AlanoudAlsalem/Dimver/report.pdf

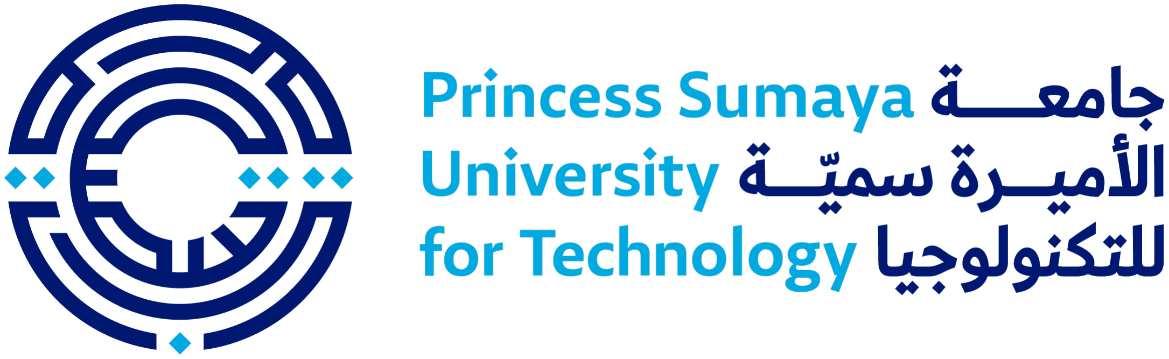
[picture p1: figure]

22583 - INTRODUCTION TO ROBOTIC SYSTEMS

PRINCESS SUMAYA UNIVERSITY FOR TECHNOLOGY

DEPARTMENT OF COMPUTER ENGINEERING

# Mobile Robot with Robotic Arm for Object Handling

Authors:
Qabas Alkaissi | (ID: 20210786)
Alanoud Alsalem | (ID: 20210371)
Leen Almousa | (ID: 20210268)
Qais Jildeh | (ID: 20210155)

### Motasem Amaireh (ID: 20190430)

Date: January 11, 2026

CONTENTS | CONTENTS

## Contents

1 Introduction | 7
2 System Overview | 7
3 Simulation Environment | 11
4 Slip Detection and Traction Control | 13
5 Data Engineering | 15
6 Machine Learning Approach | 18

CONTENTS | CONTENTS
7 Real-Time Deployment & Control | 20
8 Global Vision & Localization | 22
8.4 Software Architecture: Laptop Vision UI & Raspberry Pi Controller . . . | 25
9 Experimental Results | 31
10 Conclusion | 36

LIST OF FIGURES | LIST OF FIGURES

## List of Figures

1 | 2-DOF Planar Arm Model showing kinematic parameters (L,θ) and dy-
| namic parameters (m,τ) | | 8
2 | Visual representation of the gravitational term G(θ) in the Euler-Lagrange
| equation. The torque depends on the horizontal projection of the center
| of mass | | 9
3 | Cirkit Design schematic illustrating the physical wiring and pin connections 10
4 | Visualization of the mobile manipulator in Gazebo (left) and RViz (right). 13
5 | Free Body Diagram of the wheel showing Torque (τ), Friction Force (Ff ),
| and Normal Force (N) | | 14
6 | Divergence of wheel speed (green) and ground speed (red) during in-
| duced slip events. The delta between the two signals constitutes the
| supervised learning target | | 17
7 | Distribution of the training dataset (N = 50,000) spanning both high-slip
| (Wall Impact) and low-slip (Normal Driving) regimes | | 20
8 | High-level closed-loop traction control system. Sensors feed real-time
| velocity data to the controller, which adjusts motor commands to prevent
| slip | | 21
9 | Finite-state machine representation of the ML-based traction controller. . | 21
10 | Calibration Pipeline from raw frame input to the output localization . . . | 23
11 | AprilTag mounted on the mobile robot for pose estimation | | 24
12 | System Architecture: Global Vision Localization. The camera {C} ob-
| serves the tag on the robot {R} to determine its position in the world
| frame {W } | | 25
13 | RMSE Reprojection Error | | 31
14 | Experimental trajectory of the mobile robot. The blue trace indicates
| the actual path recorded by the global vision system, while red markers
| denote the sequential target waypoints | | 32
15 | System step response and convergence analysis. Vertical spikes indicate
| the reception of new goal commands, followed by exponential decay in
| position error | | 33
16 | Operational timeline showing state transitions. The correlation between
| ’Stationary’ phases (Grey) and ’Arm Events’ (Red lines) confirms that idle
| time was utilized for manipulation tasks | | 34
17 | Vision system availability map. Green regions indicate valid tracking,
| while red regions represent signal loss due to occlusion, handled by the
| FSM safety logic | | 34

LIST OF TABLES | LIST OF TABLES
18 | Slip Dynamics (|λˆ|). (a) The unmitigated controller (red) exhibits er-
| ratic slip behavior with sustained violations of the stability threshold
| (λth = 0.2). (b) The proposed ML+FSM controller (blue) rapidly detects
| incipient slip and modulates velocity, triggering a fast recovery (0.16s)
| and preventing loss of control | | 35

## List of Tables

1 | Dimensions and masses of the mobile manipulator extracted from the
| URDF | | 11
2 | PID gains for the arm trajectory controller, taken from the YAML config-
| uration | | 12
3 | Slip detection and mitigation parameters | | 22
4 | UDP command messages (Laptop → Raspberry Pi) | | 28
5 | Comparison of slip mitigation strategies. *The Threshold Clamp failed to
| regain traction, spinning in place for the full duration, rendering position
| error invalid | | 35

LIST OF TABLES | LIST OF TABLES

## Abstract

This work presents the design, modeling, and simulation of a mobile manipulation system that integrates navigation, manipulation, learning-based slip estimation, and vision-based localization within a unified control framework. A key challenge addressed is wheel slip, which violates the no-slip assumptions underlying classical mobile robot kinematics and leads to degraded odometry and control performance.

To address this, a supervised learning–based slip estimation model is trained using simulation-generated data, leveraging direct access to ground-truth dynamics during offline training while relying solely on onboard proprioceptive sensing during deployment. The learned slip estimator is embedded within a real-time finite-state traction controller that dynamically adapts wheel commands to maintain stability under low-traction conditions.

The complete system is implemented and evaluated in a ROS–Gazebo environment, combining analytical kinematic modeling, data-driven learning, and structured control logic. Experimental results demonstrate stable navigation, effective slip mitigation, and robust operation despite significant perception outages in the global vision system, highlighting the benefits of hybrid analytical–learning approaches for mobile manipulation under realistic physical constraints.

2 SYSTEM OVERVIEW

## 1 Introduction

This project focuses on the design and simulation of a mobile robot equipped with a robotic arm for autonomous navigation and object handling. The system integrates modeling, control, machine learning, and vision to address real-world challenges such as wheel slip and localization uncertainty.

### 1.1 Objectives

- To design a mobile manipulator capable of navigation and object handling.
- To derive and implement the kinematic model required for arm control.
- To develop a realistic simulation environment for validation and data generation.
- To detect and estimate wheel slip using machine learning and proprioceptive data.
- To integrate slip estimation into a real-time traction control framework.
- To implement a global vision localization and evaluate overall performance.

### 1.2 Problem Statement

Conventional mobile robot control and localization frameworks assume ideal rolling conditions and reliable sensing. In practice, wheel slip, actuator limits, and sensor occlusions introduce errors that accumulate over time and can lead to unstable behavior or task failure. The problem addressed in this work is how to reliably estimate and mitigate wheel slip, while maintaining accurate control and localization in a mobile manipulation system, using only onboard sensing and simulation-derived learning [11][8].

## 2 System Overview

### 2.1 Mathematical Modeling

### 2.1.1 Manipulator Forward Kinematics

Forward kinematics allows us to calculate the Cartesian position (x,y) of the end-effector (the gripper) relative to the robot’s base frame, given the joint angles θ1 and θ2

We assume the arm operates in a 2D plane. Using simple geometry and trigonometric projections, the position equations are:

x = L1 cos(θ1

) + L2 cos(θ1 + θ2

)
y = L1 sin(θ1

) + L2 sin(θ1 + θ2

)

where:

2.1 Mathematical Modeling | 2 SYSTEM OVERVIEW

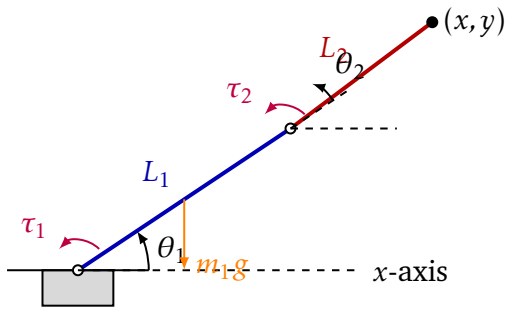
[picture p2: figure]
x-axis

Figure 1: 2-DOF Planar Arm Model showing kinematic parameters (L,θ) and dynamic parameters (m,τ).

- L1

,L2 are the lengths of the first and second links, respectively.
- θ1

is the angle of the first link relative to the base x-axis.
- θ2

is the angle of the second link relative to the first link.

### 2.1.2 Manipulator Inverse Kinematics

Inverse kinematics is required to determine the necessary joint angles (θ1

,θ2) to reach
a specific target coordinate (x,y). We utilize the geometric approach (Law of Cosines) to solve for these angles. First, we solve for the elbow angle, θ2

. By visualizing a triangle formed by L1

, L2

, and the distance to the origin r =

p
x

2 + y

2, we apply the Law of
Cosines:

cos(θ2

) =

x

2 + y

2 − L

2
1

− L

2
2
2L1L2
Thus, θ2 can be calculated as:

θ2 = atan2
±

q
1 − cos²(θ2
),cos(θ2

)

Next, we solve for the base angle, θ1

:

θ1 = atan2(y, x) − atan2(L2 sin(θ2

),L1 + L2 cos(θ2

))

### 2.1.3 Forces & Torques for Arm Motion

To control the arm effectively, we must determine the torques (τ) required at each joint to achieve desired accelerations. We model the dynamics using the Euler-Lagrange[10] equation:

τ = M(θ)θ¨ + C(θ,θ˙ ) + G(θ) | (1)

Where:

2 SYSTEM OVERVIEW | 2.2 Electrical Design
- θ = [θ1
,θ2

]

T
is the vector of joint angles.
- M(θ) is the symmetric Inertia Matrix.
- C(θ,θ˙
) represents Coriolis and Centrifugal forces.
- G(θ) represents Gravitational forces.

Lever Arm = Lc cos(θ)

r = Lc

Axis of
Rotation

F = mg

θ

### Gravitational Term G(θ)

Figure 2: Visual representation of the gravitational term G(θ) in the Euler-Lagrange equation. The torque depends on the horizontal projection of the center of mass.

### 2.2 Electrical Design

This subsection presents an overview of the proposed mechanical structure and electrical architecture of the robot. The system incorporates various sensors, actuators, and controllers that work together to ensure reliable motion and sensing, while enabling coordinated operation of all components within the overall system.

### 2.2.1 Circuit Setup

an electrical circuit diagram of the robot system was created using cirkit design. This diagram depicts the physical wiring and pin connections between all three of the major components (controllers, sensors, and actuators). The diagram serves as a reference for how each component is electrically connected rather than describing the internal control logic of the system. The MegaPi controller is connected to two IR sensors, two impact sensors, and two line follower sensors via digital and analog input pins, as well as four DC motors connected to the MegaPi motor ports, which power the mecanum wheel mechanism, allowing movement of the robot. Three servo motors are connected to the Raspberry Pi which actuate the 2DOF robotic arm; the motors receive power from

2.2 Electrical Design | 2 SYSTEM OVERVIEW

an external 5v, however the control signals are coming from the appropriate GPIO pins of the Raspberry Pi. The Raspberry Pi and the MegaPi are connected via USB, allowing communication between the two boards while maintaining separate wiring for sensors, motors, and servos. The presented circuit design ensures correct signal routing, stable operation, and ease of implementation during system assembly.

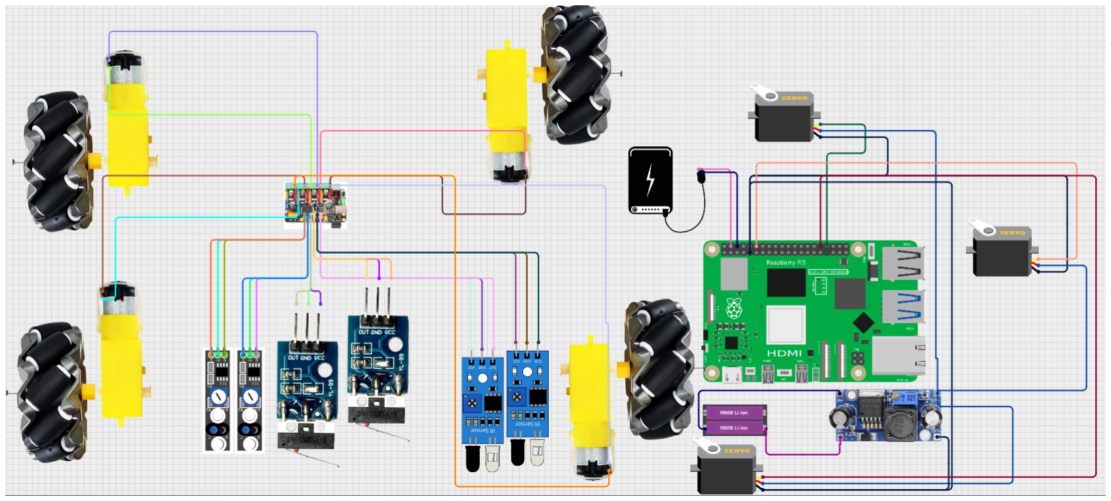
[picture p3: figure]

Figure 3: Cirkit Design schematic illustrating the physical wiring and pin connections

### 2.2.2 Differential Drive

The robot has four DC motors, and its mechanical configuration features mecanum wheels and allows for omnidirectional movement. The robot can move forward or backward, sideways and rotate around its vertical axis; each wheel is independently powered so that it may move independently of the others. Motor speed and direction are regulated by a MegaPi controller, which maintains an optimal velocity for each wheel to allow for controlled lateral movement. This extends the concept of traditional differential drive by allowing for additional degrees of freedom which enhances its capability to navigate through visually restricted areas.

### 2.2.3 Power & Energy Considerations

Power management considerations have been given serious thought to maintain the robot system’s consistent and dependable operation under diverse loading situations. Servos draw high amounts of current and exhibit rapid snap action, this, the robotic arm subsystem has been designed to operate independently from the rest of the robot. Thus, three servos that actuate the 2-DOF robotic arm are driven by a 7.2 V external battery and fed through a regulated DC-DC voltage converter at an output voltage of around

3 SIMULATION ENVIRONMENT

5-6 V to meet the required operating voltage for the servo motors, which will prevent excessive loading on the primary power supply circuit and lessen the risk of voltage drops occurring during arm motion. All of the remaining components of the system are powered through a power bank that is connected to the Raspberry Pi and provides a stable voltage for computation, sensing, and mobile navigation, which also simplifies the overall method of power distribution across the robot. By selecting different power sources to power the high-current actuators and sensitive electronic devices separately, the system reduces EMC noise, enhances system reliability, and promotes consistent operation during simultaneous robot operation and motion of the robot arm.

## 3 Simulation Environment

A ROS–Gazebo simulation was developed to evaluate the mobile manipulator. The simulation environment provides a repeatable platform for testing the robot model, its controllers, and the interaction between the mobile base and the manipulator arm before deployment on real hardware.

### 3.1 Robot Model and Mechanical Design

The robot is described using URDF, which defines its geometry, kinematic structure, inertial properties, and collision models. The complete system consists of:

- A four–wheel skid–steer mobile base.
- An arm base pedestal and waist assembly.
- A vertical pillar link mounted to a gripper with two prismatic fingers coupled through a mimic joint.

All geometric dimensions and masses used in the simulation are taken directly from the URDF and are summarized in Table 1.

Component | Dimensions | Mass
Base chassis (base link) | 190 × 140 × 57.5mm | 1.3103kg
Drive wheel (each) | 60 × 25mm | 44g
Arm base pedestal (arm base pedestal) | 25 × 55 × 45mm | 83g
Waist housing (link waist) | 25 × 55 × 65mm | 25g
Main pillar link (arm pillar link) | 25 × 43 × 105mm | 126g

Table 1: Dimensions and masses of the mobile manipulator extracted from the URDF.

The gripper fingers are actuated through a prismatic joint gripper joint, while the second finger moves symmetrically through gripper joint mimic using a mimic rela-

3.2 Control Configuration | 3 SIMULATION ENVIRONMENT

tionship with multiplier −1.0. This configuration produces synchronized, symmetric opening and closing of the gripper.
Realistic inertial parameters (mass, center of mass) are specified for each link. These values suppress unrealistic accelerations and oscillations and lead to physically consistent motion in Gazebo.

### 3.2 Control Configuration

Joint-level control is implemented using the ros control framework. A joint state controller publishes the current joint states at 50Hz, while a joint trajectory controller commands the arm joints (joint1, joint2, and gripper joint) in position mode. The main PID gains for the trajectory controller are defined in an external YAML configuration file and are summarized in Table 2. Separate PID gains are also selected for the gazebo ros control plugin, which provides additional stabilization of the joints.

Joint | P | I | D
joint1 | 100.0 | 0.1 | 10.0
joint2 | 100.0 | 0.1 | 10.0
gripper joint | 50.0 | 0.01 | 1.0

Table 2: PID gains for the arm trajectory controller, taken from the YAML configuration.

Trajectory constraints are also set in the YAML file, including a goal completion time of 0.6s and a stopped-velocity tolerance of 0.05rad/s, with tighter goal tolerances for the individual joints. These settings ensure smooth convergence to the target configuration without excessive overshoot.
The mobile base is controlled through a skid–steer drive plugin. Velocity commands issued on cmd vel are translated into wheel velocities for the four wheel joints using the specified wheel separation of 165mm and wheel diameter of 60mm. In parallel, the manipulator arm is controlled by a joint trajectory controller, which receives desired joint trajectories and computes the corresponding position commands for joint1, joint2, and gripper joint. This allows the arm and mobile base to be operated together in a coordinated manner during the simulation.

### 3.3 Dynamics and Validation

The Gazebo physics engine simulates gravity, friction, contact interactions, and joint dynamics.
The simulation was used to assess:
- Tracking accuracy of joint1, joint2, and the prismatic gripper joint.
- Stability of the arm under different motion speeds.

4 SLIP DETECTION AND TRACTION CONTROL

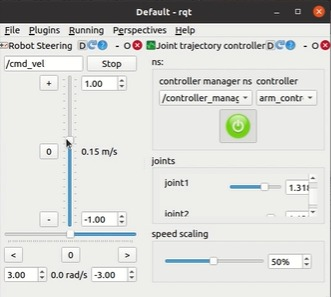
[picture p4: figure]
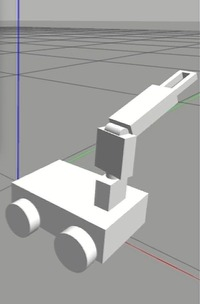
[picture p5: figure]

Figure 4: Visualization of the mobile manipulator in Gazebo (left) and RViz (right).

- Coordinated opening and closing of the mimic gripper.
- Combined operation of the mobile base and manipulator.

The final configuration exhibited smooth, stable motion. The link dimensions and masses derived from the URDF produced realistic dynamic behavior, indicating that the model, controllers, and plugins are correctly integrated and that the system is functional.

## 4 Slip Detection and Traction Control

Most mobile robots assume no-slip conditions during motion. This assumption often breaks down in unstructured environments such as mud, ice, or during collisions, resulting in odometry drift and eventual localization failure. Slip cannot be measured directly without costly external sensing systems, which motivates the need to infer slip from internal proprioceptive data.

While slip is classically defined as a normalized ratio, this work models slip as the absolute divergence between wheel-induced velocity and ground-truth velocity. This formulation is more directly actionable for real-time control, as it maps linearly to velocity correction commands. A nonlinear regression model can be employed to estimate the unobservable slip state, λ, using only observable quantities: wheel angular velocity ωw and commanded velocity vcmd.

4.1 Mathematical Definition of Slip 4 SLIP DETECTION AND TRACTION CONTROL

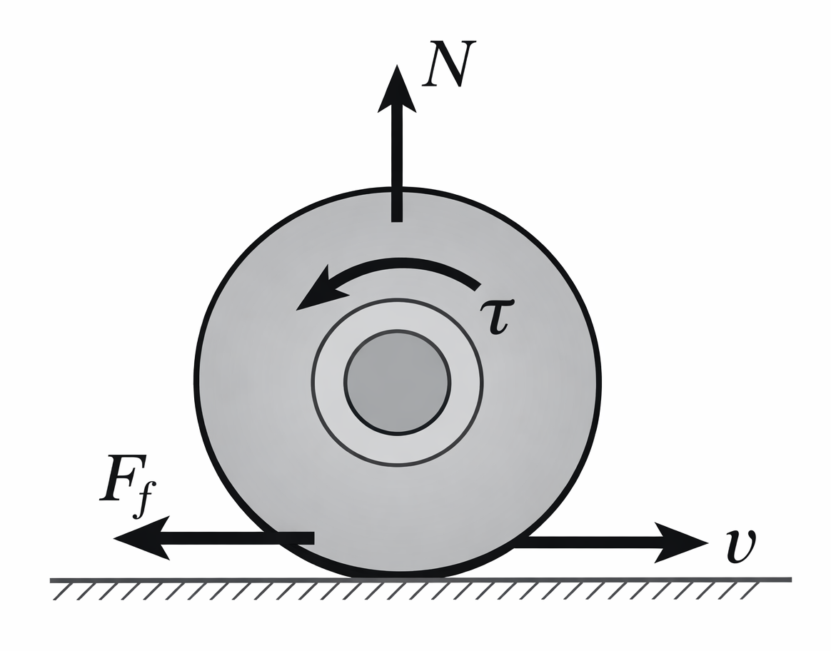
[picture p6: figure]

Figure 5: Free Body Diagram of the wheel showing Torque (τ), Friction Force (Ff ), and Normal Force (N)

### 4.1 Mathematical Definition of Slip

Slip is defined as the discrepancy between the wheel-induced motion and the actual ground motion of the robot[8, 4]. The slip ratio is given by

λ = 1 −

vground

r · ωwheel

(2)

where:

- λ is the slip ratio, with λ = 0 indicating pure rolling and λ = 1 indicating burnout,
- vground is the true linear velocity of the robot relative to the ground (ground truth),
- ωwheel is the angular velocity of the wheel,
- r is the wheel radius, fixed at r = 0.03m.

All experiments were conducted using the Gazebo simulator, which employs the Open Dynamics Engine (ODE) to solve rigid body dynamics and contact interactions. Gazebo was selected due to its widespread adoption in robotics research and its ability to expose low-level physical parameters relevant to wheel–terrain interaction.

### 4.1.1 Slip-Inducing Physics Configuration

To ensure the presence of wheel slip during simulation, the default contact and actuation parameters in Gazebo were intentionally modified. Under nominal settings, the physics engine implicitly enforces near no-slip behavior by limiting wheel torque and angular velocity, effectively preventing sustained wheel spin under load.
To emulate low-traction, ice-like terrain conditions, both the primary and secondary friction coefficients were reduced to

5 DATA ENGINEERING

µ = µ2 = 0.1 | (3)
Additionally, the joint actuation limits were increased to allow free wheel rotation under resistive contact:
- The max. joint effort (max effort) was increased to 20.0,
- The joint velocity constraint was relaxed to permit sustained wheel spin.

These modifications enable the simulation of extreme slip regimes, including burnoutlike behavior, while maintaining physically consistent rigid body dynamics.

### 4.1.2 Hidden Sensor Method

Standard odometry outputs (e.g., the /odom topic) rely on no-slip kinematic assumptions and therefore become unreliable under slip conditions. To avoid this limitation, raw wheel joint states were extracted directly from the /joint states topic, providing access to low-level proprioceptive measurements unaffected by odometry fusion.
The wheel-induced linear velocity was computed by averaging the angular velocities of all four wheels and mapping them to linear motion as

vwheel =

1
4

X

4

i=1

θ˙
i
·r | (4)

where:
- θ˙
i denotes the angular velocity of the i-th wheel.
- r is the wheel radius.

This formulation assumes symmetric wheel geometry and equal contribution from each driven wheel. The resulting vwheel signal, together with the commanded velocity vcmd, forms the observable input space used for slip estimation.

## 5 Data Engineering

### 5.1 Automated Data Generation Pipeline

### 5.1.1 Methodology: Automated Simulation Control

Data collection was fully automated via a Python script (collect data.py) that orchestrates the Gazebo simulation loop, robot actuation, and sensor logging. Each trial consists of issuing a commanded velocity, recording wheel kinematics, and exporting synchronized state vectors at a fixed simulation timestep.
The automation ensures scalability and eliminates human bias, enabling the generation of large, statistically meaningful datasets suitable for supervised learning[14, 13].

5.1 Automated Data Generation Pipeline | 5 DATA ENGINEERING

### 5.1.2 State Reset and I.I.D. Trials

To guarantee independent and identically distributed (I.I.D.) samples, the simulation environment is treated as a memoryless system between trials. Simply driving the robot back to the start is insufficient, as it introduces residual integrator error and non-zero momentum.
Instead, a ”hard reset” is enforced using the Gazebo state API. Let the robot state vector x(t) be defined as the concatenation of pose and twist:

x(t) =

p(t)
q(t)
v(t)
ω(t)

∈ R
13 | (5)

Where p is Cartesian position, q is the quaternion orientation, v is linear velocity, and ω is angular velocity.
At the initialization of every trial k, the state is forced to a fixed initial condition x0

,
ensuring zero variance in the starting distribution:

xk

(t = 0) ← x0 =

03×1
[0,0,0,1]T

03×1
03×1

(6)

This operation effectively zeros out all kinetic energy (Ek =

1
2mv² = 0), preventing historical velocity correlations from contaminating the subsequent dataset.
This reset enforces identical initial conditions across runs, preventing temporal correlation and trajectory memory from contaminating the dataset. As a result, each slip event is treated as an independent realization of the underlying physical process.

### 5.1.3 Variance Injection via Environment Extremes

To maximize model generalization, variance was deliberately injected by collecting data under two extreme environmental conditions:

- Wall Impact (100% Slip): Induced by commanding motion into an immovable obstacle, forcing wheel rotation without ground displacement.
- Empty World (0% Slip): Free-space motion on uniform terrain, representing nominal traction conditions.

The merged dataset exposes the model to the full slip spectrum, preventing biased learning and improving robustness under real-world ambiguity.

5 DATA ENGINEERING | 5.2 Visual Evidence of Slip Dynamics

### 5.1.4 Dataset Specifications

The final dataset characteristics are summarized as follows:

- Total Samples (N): ∼ 50,000 (merged dataset)
- Sampling Rate: 100 Hz (Gazebo simulation step)
- Feature Vector:
X = [vcmd, vwheel] | (7)
- Target Variable:
y = vwheel − vground | (8)

This formulation directly models slip as the divergence between wheel-induced motion and actual ground displacement.

### 5.2 Visual Evidence of Slip Dynamics

The characteristic “alligator mouth” shape highlights the non-linear and discontinuous nature of slip, motivating the choice of non-linear regression models.

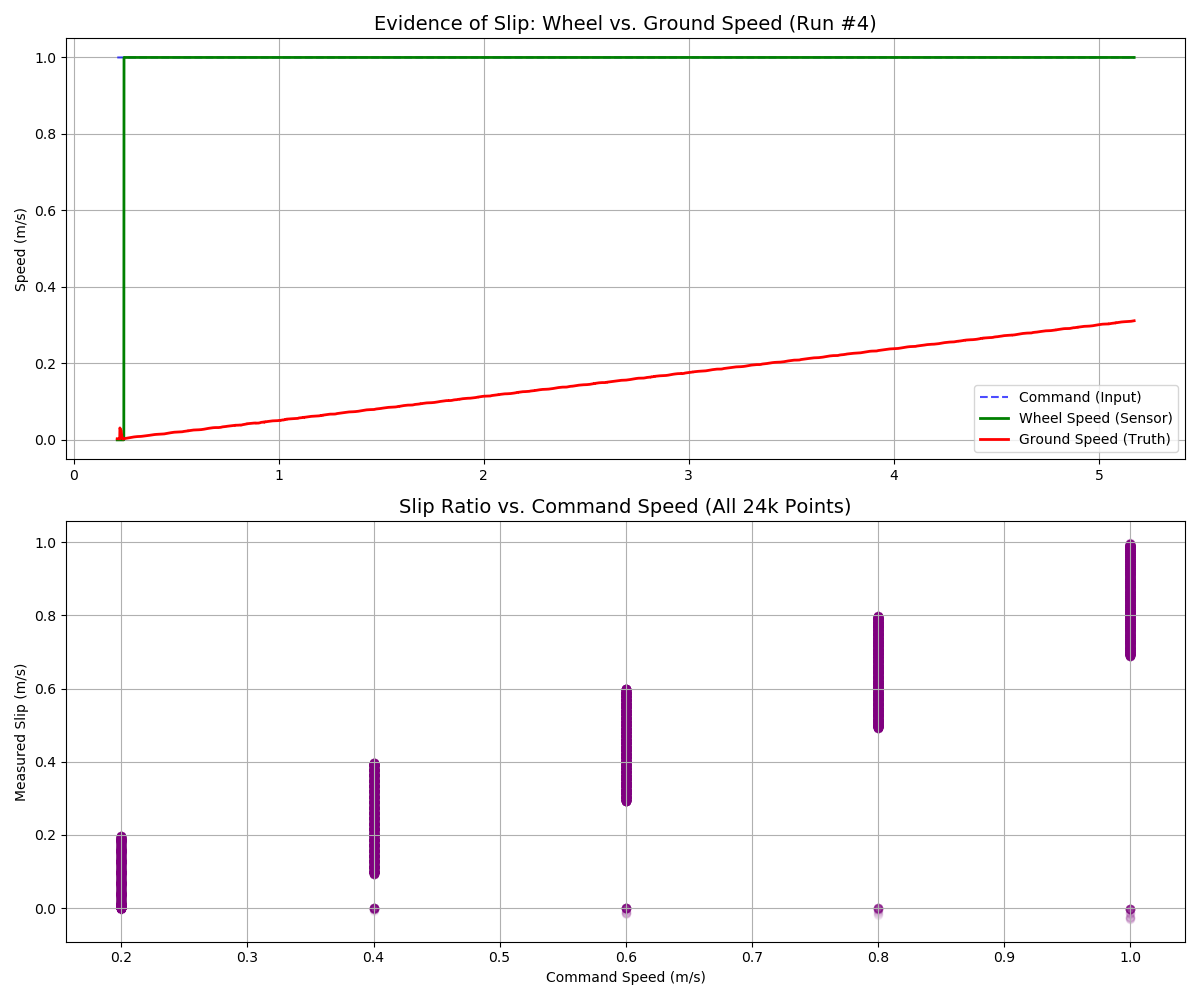
[picture p7: figure]

Figure 6: Divergence of wheel speed (green) and ground speed (red) during induced slip events. The delta between the two signals constitutes the supervised learning target.

6 MACHINE LEARNING APPROACH

## 6 Machine Learning Approach

### 6.1 Model Selection: Random Forest Regressor

A Random Forest Regressor was selected to estimate slip magnitude from proprioceptive inputs[15, 7]. Random Forests provide strong non-linear modeling capacity with minimal tuning overhead.

Linear regression was not used because it fails to capture the underlying dynamics due to the inherently non-linear relationship between commanded velocity, wheel rotation, and traction. Empirically, slip manifests as a discontinuous, staircase-like response rather than a smooth linear trend.

Neural Networks were also not used for the ML Approach. Although neural networks are expressive, they were deemed unnecessary for this task due to:

- Limited feature dimensionality
- Increased training complexity
- Higher risk of overfitting given synthetic data

The Random Forest model offers various advantages, including robustness to sensor noise, implicit regularization via ensemble averaging, and interpretability through feature importance analysis.

### 6.2 Performance Metrics and Validation

### 6.2.1 Evaluation Results

Model performance was evaluated using a standard 80/20 train-test split, where 80% of the dataset was used for training and the remaining 20% was held out for evaluation. Performance was quantified using the coefficient of determination (R

2
) and the
mean squared error (MSE), which together assess both explanatory power and absolute prediction accuracy.

Coefficient of Determination (R

2
). The coefficient of determination measures the proportion of variance in the target variable explained by the regression model and is defined as:

R

2 = 1 −

PN
i=1(yi − yˆi

)

2
PN
i=1(yi − y¯)

2

(9)

where:

- yi denotes the ground-truth slip value
- yˆi

the model prediction

6 MACHINE LEARNING APPROACH 6.3 Ground Truth and Slip Label Generation

- y¯ the mean of the ground-truth values
- N the number of test samples

An R

2
score of approximately 0.95 indicates that the model has a strong alignment between predicted and true slip dynamics across diverse operating conditions.

Mean Squared Error (MSE). The mean squared error quantifies the average squared deviation between predicted and true values and is given by:

MSE =

1
N

X

N

i=1

(yi − yˆi

)

2
(10)

Unlike R

2
, MSE preserves the physical units of the target variable squared, providing an absolute measure of prediction accuracy. The low observed MSE indicates that prediction errors remain tightly bound, even during high-slip transients.

Metric Complementarity. While R

2 evaluates how well the model explains variance in slip behavior, MSE reflects the magnitude of residual errors. Reporting both metrics provides a balanced assessment, ensuring that high variance explanation does not mask large absolute errors in critical slip regimes.

### 6.2.2 Bias and Overfitting Correction

An initial version of the model exhibited false-positive slip detection on flat, hightraction terrain. This bias was traced to an overrepresentation of slip-heavy scenarios in the training data. The issue was mitigated by injecting additional control data from Empty World simulations, effectively anchoring the model’s baseline behavior. This correction significantly reduced false detections without degrading sensitivity to genuine slip events.

### 6.3 Ground Truth and Slip Label Generation

Slip cannot be directly measured in real-world deployments without external sensing infrastructure. However, simulation provides direct access to ground-truth robot kinematics. The true ground velocity vground was extracted from the simulator state and used exclusively for offline label generation.
For each timestep, the slip target was computed as:
λ = vwheel − vground | (11)

The slip labels were stored alongside proprioceptive measurements to form the supervised learning dataset. It is emphasized that vground is never available during inference

7 REAL-TIME DEPLOYMENT & CONTROL

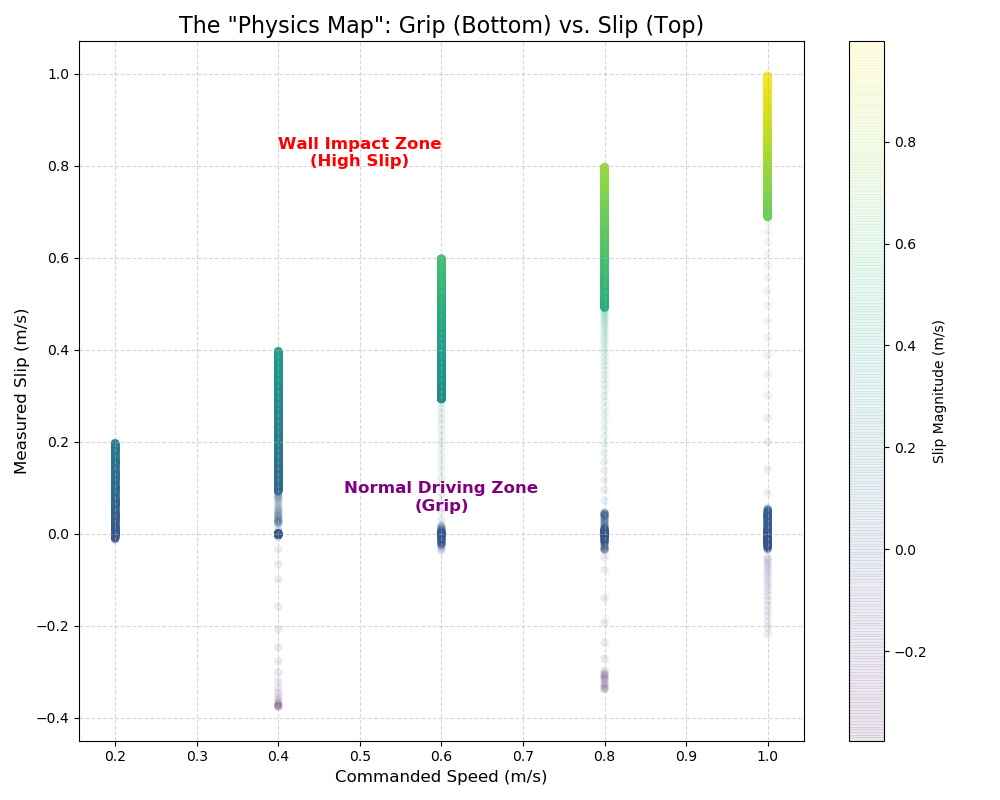
[picture p8: figure]

Figure 7: Distribution of the training dataset (N = 50,000) spanning both high-slip (Wall Impact) and low-slip (Normal Driving) regimes.

and is used solely as a supervisory signal during model training and evaluation. It is emphasized that ground-truth velocities are available only within simulation and are used exclusively for offline label generation. During online deployment, slip estimation relies solely on proprioceptive measurements available on the robot.

## 7 Real-Time Deployment & Control

### 7.1 Closed-Loop Feedback

The traction control system operates in a closed-loop configuration, continuously monitoring wheel velocities to maintain optimal traction[2]. Figure 8 shows the high-level control architecture.

### 7.2 State-Space Representation of Traction

To ensure robust operation in the presence of sensor noise and simulation jitter, the control system is modeled as a finite-state machine (FSM)[1], as illustrated in Figure 9.

1. Normal Traction (S0): tracking reference velocity while slip is below threshold.
2. Suspected Slip (S1): Transitional state acting as a filter to reject transient noise.

7 REAL-TIME DEPLOYMENT & CONTROL7.2 State-Space Representation of Traction

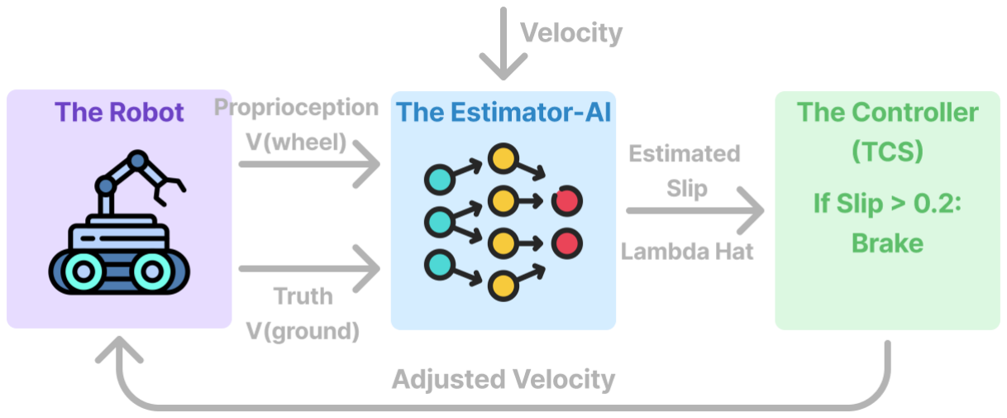
[picture p9: figure]

Figure 8: High-level closed-loop traction control system. Sensors feed real-time velocity data to the controller, which adjusts motor commands to prevent slip.

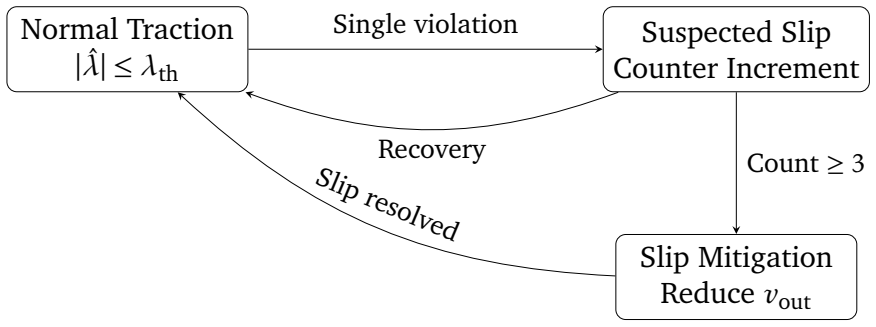
[picture p10: figure]
Normal Traction |λˆ| ≤ λth; Suspected Slip Counter Increment; Slip Mitigation Reduce vout; Single violation; Recovery; Count ≥ 3; Slip resolved

Figure 9: Finite-state machine representation of the ML-based traction controller.

7.3 Control Parameters | 8 GLOBAL VISION & LOCALIZATION
3. Slip Mitigation (S2): Active intervention state after Γ consecutive slip violations, reducing wheel velocity to recover traction.

### 7.3 Control Parameters

Table 3 summarizes key control parameters used in the FSM-based traction controller.

Table 3: Slip detection and mitigation parameters.

Symbol Parameter Name | Value | Description
λˆ | Estimated Slip | Output | Real-time prediction (m/s)
λth | Safety Threshold | 0.20 m/s Compromised Traction Limit
Γ | Filter Window | 3 frames Violations before Mitigation
α | Mitigation Factor | 0.10 | Slip Velocity Decay Rate
β | Acceleration Gain | 0.05 | Gain during Velocity Ramp-up

### 7.4 System Behavior

During operation, the controller may oscillate around an intermediate velocity. This is a limit cycle reflecting the system dynamically estimating the maximum coefficient of friction (µmax) of the terrain. The controller maintains stability and prevents wheel slip while adapting to available traction. The ROS node live slip detector.py executes the model in real-time with < 10ms latency, supporting 10Hz control loops reliably.

## 8 Global Vision & Localization

### 8.1 Camera Setup & Calibration

To track the robot’s position within the workspace, we utilize a fixed overhead camera positioned at the corner of the room. This setup creates a ”Global Observer” architecture where the state estimation is decoupled from the robot’s onboard sensors. Before operation, we perform camera calibration using a Checkerboard pattern. This process allows us to determine:

- Intrinsic Parameters (K): The camera’s focal length (fx
, fy

) and optical center
(cx
, cy

), used to correct lens distortion.
- Extrinsic Parameters (R, T ): The rotation and translation matrices that define the camera’s position relative to the global World Frame {W }.

8 GLOBAL VISION & LOCALIZATION | 8.2 Tag-Based Pose Estimation

Intrinsic calibration mitigates curvature near the edges of the image and positiondependent holography. A printed checkerboard with 7x10 inner corners and real-world dimensions of 107x147.3 cm is used for calibration. By taking many pictures of the checkerboard at different positions, a collection of 3D points, mapped to the checkerboard corners, and their corresponding 2D pixel locations are obtained. The OpenCV library computes the resulting camera matrix K, distortion coefficients, and RMS reprojection error.

It is important that each image contributes to different angles, corner positions, and regions of the lens. This allows OpenCV to differentiate between true perspective geometry and lens distortion. Homography assumes linear projective geometry, and lens distortion breaks that assumption, which makes undistortion a requirement that must be satisfied before conducting homography. This brings the overall pipeline to:

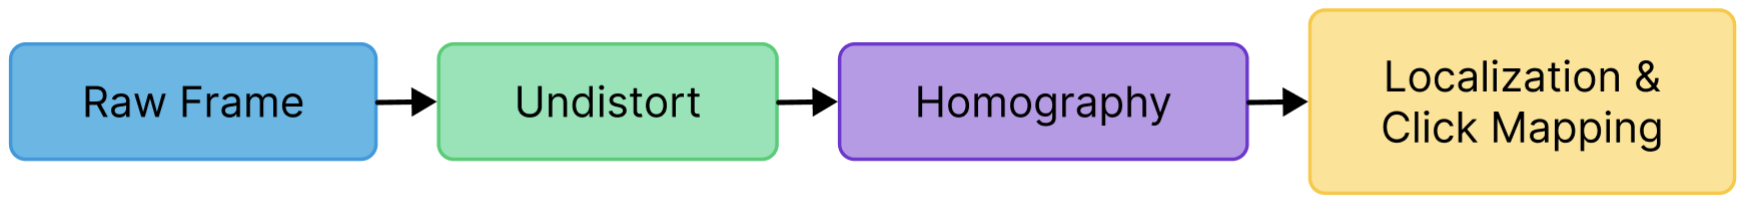
[picture p11: figure]

Figure 10: Calibration Pipeline from raw frame input to the output localization

As for the 4-click calibration, it maps a point from the undistorted image to the floor. The camera being at a fixed position, rigidly mounted allows for one-time calibration as long as the resolution and zoom do not change.
This pipeline allows for AprilTag localication and hence rover localization within the camera frame.

### 8.2 Tag-Based Pose Estimation

We equip the mobile robot with a fiducial marker (e.g., ArUco or AprilTag) on its top surface. The vision system detects the marker’s corners in the image frame and solves the Perspective-n-Point (PnP) problem to recover the robot’s pose[12, 6].
The transformation from a 2D pixel coordinate (u, v) in the image to a 3D coordinate (Xc
,Yc

,Zc

) in the camera frame is modeled by the pinhole camera equation:

s

u
v
1

=

fx | 0 cx
0 fy | cy
0 0 1

r11 r12 r13 tx
r21 r22 r23 ty
r31 r32 r33 tz

Xw
Yw
Zw
1

where:

- s is a scaling factor.

8.3 Path Planning & Control Loop | 8 GLOBAL VISION & LOCALIZATION

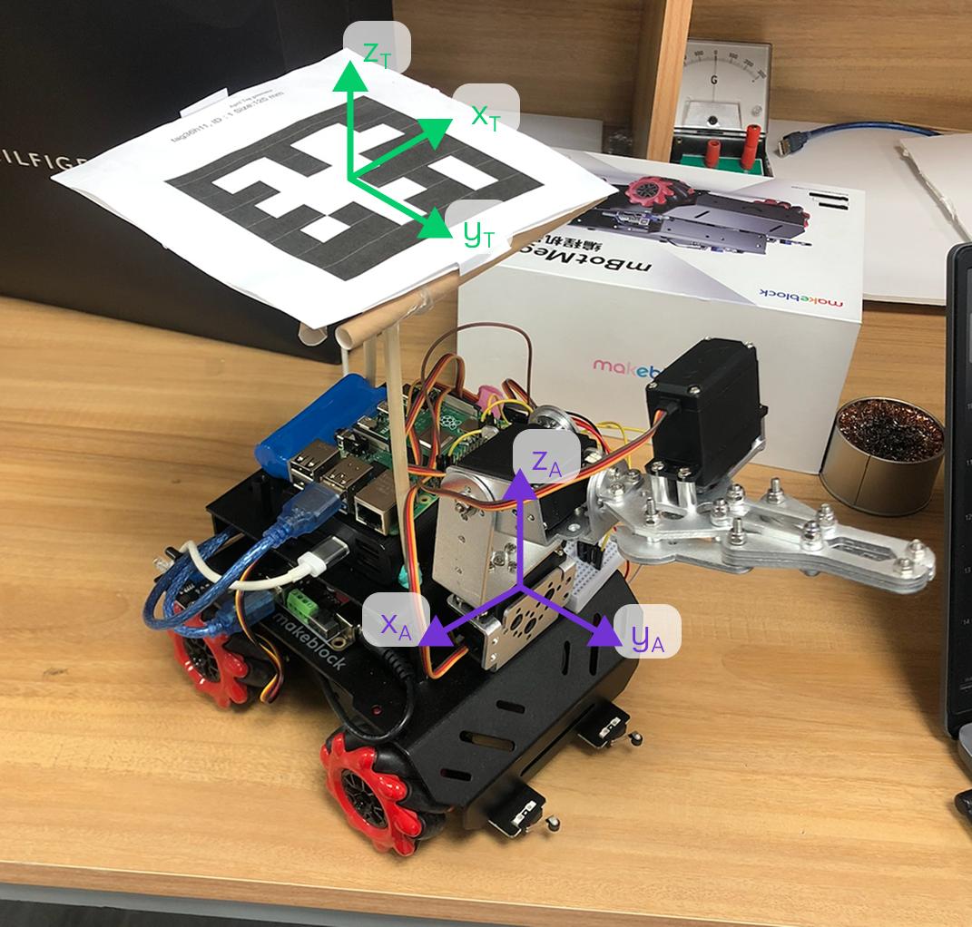
[picture p12: figure]

Figure 11: AprilTag mounted on the mobile robot for pose estimation.

- The first matrix is the Intrinsic Matrix (K).
- The second matrix contains the Extrinsic Rotation (R) and Translation (T ).

Using the known size of the tag and its detected corner positions in the image, we can solve for the robot’s 6-DOF pose relative to the camera frame {C}. This pose is then transformed into the World Frame {W } using the following transformation matrix:

TA =

−1 0 0 −1
0 1 0 8
0 0 1 −14
0 0 0 1

### 8.3 Path Planning & Control Loop

The central laptop acts as the high-level controller. The control loop operates as follows:

8 GLOBAL VISION & LOCALIZATION8.4 Software Architecture: Laptop Vision UI & Raspberry Pi Controller

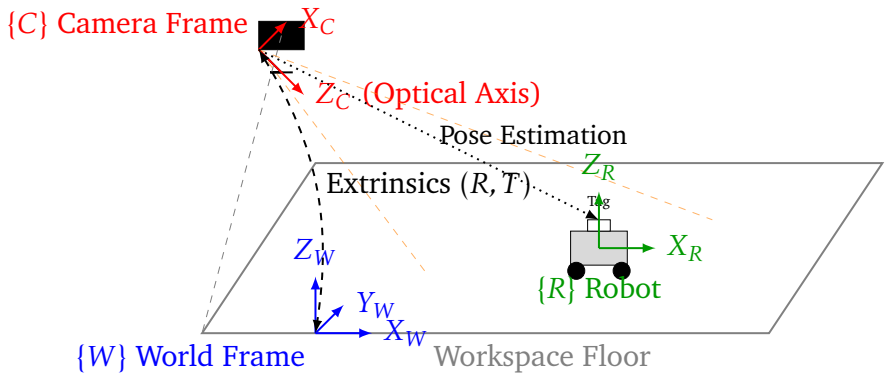
[picture p13: figure]
Workspace Floor; {W } World Frame; ZC (Optical Axis); {C} Camera Frame; Tag; {R} Robot; Extrinsics (R, T ); Pose Estimation

Figure 12: System Architecture: Global Vision Localization. The camera {C} observes the tag on the robot {R} to determine its position in the world frame {W }.

### 8.4 Software Architecture: Laptop Vision UI & Raspberry Pi Controller

The global vision subsystem is implemented as a distributed stack across two compute nodes:

- Laptop (Vision UI + Calibration + Logging): captures video frames, performs camera calibration and undistortion, computes a planar homography for pixel-toworld mapping, detects the fiducial tag on the rover, estimates the rover pose (x,y,ψ) in the world frame, provides an interactive operator UI (click-to-goal and arm buttons), and logs all run artifacts (pose stream, events, and annotated video).
- Raspberry Pi (Low-level Controller + Safety + Arm): receives the pose stream and operator commands via UDP, runs the navigation/avoidance controller, commands the mobile base through the MegaPi serial bridge, and actuates the robotic arm via PWM servos with an explicit safety interlock that forces the rover to stop during manipulation.

This separation isolates compute-heavy vision/UI tasks on the laptop, while keeping actuation and safety-critical decision logic local to the robot.

### 8.5 Coordinate Frames and Geometric Assumptions

The localization pipeline operates in three coordinate frames:

1. Image frame (pixels): a 2D pixel coordinate is denoted (u, v).
2. World frame (meters, planar): a 2D ground-plane coordinate is denoted (x,y) in meters.

8.6 Camera Intrinsic Calibration and Online Undistortion8 GLOBAL VISION & LOCALIZATION

3. Rover yaw (radians): the rover heading is denoted ψ (computed from tag geometry and then corrected on the Raspberry Pi by a constant offset).

Because the robot operates on a flat floor, the pixel-to-world mapping is modeled using a single planar homography H (projective transform). Camera lens distortion violates projective linearity; therefore, undistortion must be applied before homography is calibrated and used.

### 8.6 Camera Intrinsic Calibration and Online Undistortion

### 8.6.1 Objective

Intrinsic calibration estimates the camera matrix K and distortion coefficients d so that raw frames can be corrected (undistorted). This improves the geometric consistency of the homography mapping and reduces localization error caused by radial/tangential lens distortion.

### 8.6.2 Checkerboard Model

A printed checkerboard is used with:

- inner-corner grid size: (7 × 10),
- square size: s = 0.13383 m,
- minimum number of samples: Nmin = 25.

For each captured sample i, OpenCV detects the inner cornersc(pixel coordinates) and pairs them with planar object points in meters. The calibration minimizes reprojection error over all samples.

### 8.6.3 Online Undistortion

During runtime, if calibration parameters exist, the laptop computes rectification maps once per resolution then applies fast remapping on each frame. If the capture resolution changes, calibration is flagged as potentially invalid and should be recomputed.

### 8.7 Planar Homography: Pixel-to-World Mapping

The mapping from a pixel coordinate (u, v) on the floor plane to a world coordinate (x,y) is modeled using a homography.
Homography is computed interactively using four clicked reference points in the undistorted image. The operator clicks the arena corners in a fixed order:
1. Top-left → (0,0)

8 GLOBAL VISION & LOCALIZATION8.8 AprilTag-Based Pose Estimation in the World Frame

2. Top-right → (W ,0)
3. Bottom-right → (W ,H)
4. Bottom-left → (0,H)

where (W ,H) are the known arena dimensions in meters. Given four pixel points pk = [uk
, vk

]

T and corresponding world points Pk = [xk ,yk

]

T
, H
is solved via standard DLT (OpenCV findHomography) and saved for reuse.

### 8.7.1 Validity Constraints

Homography is valid only for the specific optical geometry used during calibration. Therefore:

- Toggling undistortion invalidates H.
- Changing capture resolution (or zoom) requires recalibration.
- Any change in camera mounting height/angle requires recalibration.

### 8.8 AprilTag-Based Pose Estimation in the World Frame

### 8.8.1 Detection and Performance Scaling

The laptop detects a tag of known ID using the tag36h11 family. For efficiency, detection runs on a downscaled grayscale image (scale factor α ∈ (0,1]). If detection occurs at scale α, the detected center and corner coordinates are mapped back to full resolution by dividing by α.

### 8.8.2 World Position

If a tag is detected and a valid homography exists, the rover position is computed by transforming the tag center:

[x y]

T = H

[uc vc

]

T

, | (12)

where H(·) denotes the homography transform.

### 8.8.3 Yaw Estimation from Tag Geometry

Let c0 and c1 be two adjacent tag corners in pixel coordinates. After transforming to world coordinates C0 = H(c0

) and C1 = H(c1

), define:

v = C1 − C0 = [vx vy

]

T
, | (13)

8.9 UDP Networking Interface and Message Protocol8 GLOBAL VISION & LOCALIZATION

then compute the yaw estimate:

ψ = atan2(vy
, vx
). | (14)

On the Raspberry Pi controller, a constant yaw correction is applied:

ψrobot = wrapToπ(ψ +ψ0

), | (15)

where ψ0

is an empirically tuned offset to align the tag’s axis with the rover forward axis.

### 8.9 UDP Networking Interface and Message Protocol

Two UDP channels connect the laptop and Raspberry Pi:

- Pose stream (Laptop → Pi): continuous telemetry of (x,y,ψ).
- Command channel (Laptop → Pi): operator events (goal, run/stop, arm).

### 8.9.1 Pose Stream

The pose sender transmits at a fixed rate (nominally 30 Hz). Each message includes a timestamp t (UNIX seconds) and a validity flag:
- Valid pose:
{t, valid = true, x, y, yaw} | (16)
- Invalid pose (tag missing or homography missing):
{t, valid = false} | (17)

On the Raspberry Pi, pose messages are rejected if they are stale:

∆t = tnow − tpose > ∆tmax, | (18)

where ∆tmax = 0.35 s.

### 8.9.2 Command Channel

Commands are event-driven and transmitted immediately on operator input. The supported command types are summarized in Table 4.

Table 4: UDP command messages (Laptop → Raspberry Pi).

Type Fields | Description
goal | x, y | Set new goal position in world meters.
run | enabled | Enable/disable rover motion.
stop | (none) | Alias to disable motion (safety stop).
arm | action | Trigger pick or place.

8 GLOBAL VISION & LOCALIZATION8.10 Operator Interface: Click-to-Goal and Arm Buttons

### 8.10 Operator Interface: Click-to-Goal and Arm Buttons

The laptop application implements a single-window operator interface:

### 8.10.1 Click-to-Goal

A left mouse click at pixel coordinate (u, v) is transformed to world (xg ,yg

) via homography:
(xg
,yg
) = H(u, v), | (19)

then transmitted as a goal command. If H is missing, the UI blocks the action and prompts homography recalibration.

### 8.10.2 On-Screen Arm Buttons

Two on-screen buttons (PICK and PLACE) are drawn in the top-right of the live frame. A click within a button rectangle sends:

{type = arm, action ∈ {pick,place}}. | (20)

Keyboard equivalents are provided for rapid operation: s (start), x (stop), p (pick), o (place).

### 8.11 Raspberry Pi Control Arbitration and Safety Interlocks

The Raspberry Pi executes the base controller at 20 Hz and selects motor commands according to a strict priority order:

1. Arm safety lock (highest priority): while an arm action is executing or queued, the rover motors are forced to zero. After the arm finishes, the rover remains stopped until the operator explicitly restarts motion.
2. Run disabled: if run enabled is false, motors remain stopped regardless of goal.
3. Impact safety: if either impact switch is triggered, the rover stops and performs a short back-off to recover from collision contact.
4. Reactive avoidance override: if IR proximity indicates a near obstacle, or pose is unavailable, the rover runs an obstacle-avoidance behavior instead of go-to-goal.
5. Go-to-goal (nominal mode): if pose is valid and the path is clear, the rover runs a proportional controller to reduce distance-to-goal and heading error.

This ensures safe behavior under occlusions, collisions, and during manipulation.

8.12 Arm Control: Non-Blocking Queue and Smooth Servo Motion8 GLOBAL VISION & LOCALIZATION

### 8.12 Arm Control: Non-Blocking Queue and Smooth Servo Motion

The robotic arm is driven by three PWM servos: base rotation, vertical joint, and gripper. The control implementation provides:

- Smooth motion: servo angles are stepped in small increments ∆θ with a fixed dwell ∆t to avoid jerky motion and reduce overshoot under load.
- Non-blocking execution: arm actions are enqueued and executed in a dedicated worker thread so the main controller loop continues to process safety and telemetry.
- Explicit safety coupling: the arm controller exposes busy and queue state; the base controller uses these signals to force-stop rover motion during manipulation.

Two high-level arm primitives are implemented:

1. Pick: neutral pose → rotate → lower → close gripper → lift (hold object).
2. Place: rotate → lower → open gripper → lift → return to neutral.

### 8.13 Run Logging and Offline Reconstruction

Each run is stored in a timestamped directory and includes:

- Annotated video (video.mp4): frame overlays include pose, goal, FPS, calibration state, and tracking status.
- Pose telemetry (pose.csv): timestamped (x,y,ψ) with validity flags.
- Event log (events.csv): goal changes, run toggles, arm triggers, and session start/end markers.
- Metadata (meta.json): configuration snapshot (ports, tag ID, world dimensions, calibration parameters, etc.) enabling reproducibility.
- Calibration diagnostics (if solved in-session): per-sample reprojection errors (calib quality.csv) and a summary visualization (calib quality.png).

An offline script reconstructs the rover path by loading pose.csv, interpolating (x(t),y(t)) onto a uniform animation timeline, and exporting a time-synchronized trajectory animation (path animation.mp4). Goal markers are overlaid by parsing events.csv and highlighting the most recent goal at each time step.

9 EXPERIMENTAL RESULTS

## 9 Experimental Results

### 9.1 Data Collection & Setup

### 9.1.1 Camera Calibration

Initially, the camera calibration performance was assessed. The root-mean-square reprojection error (RMSE px) quantifies the average discrepancy, in pixel units, between the observed checkerboard corner locations and their corresponding projections computed using the estimated camera intrinsic parameters and distortion model. As such, RMSE px serves as a direct measure of how accurately the calibrated camera model represents the true imaging geometry [5].

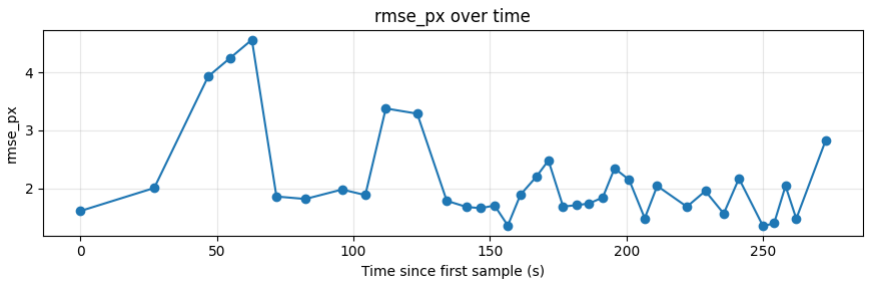
[picture p14: figure]

Figure 13: RMSE Reprojection Error

Across the calibration dataset, the RMSE px values remain predominantly within the range of approximately 1.5–2.5 pixels, with a median value of 1.87 pixels. This indicates that, for the majority of calibration images, the projected corner locations deviate from the detected corners by fewer than two pixels on average, which is generally considered acceptable for camera calibration in robotics and computer vision applications. However, a small number of calibration images exhibit significantly higher RMSE px values, exceeding 4 pixels. These outliers correspond to frames where corner detection accuracy is likely degraded, potentially due to motion blur, suboptimal lighting conditions, partial visibility of the checkerboard, or extreme viewing angles. The presence of these outliers inflates the upper tail of the error distribution but does not reflect the typical calibration performance.

### 9.1.2 Information Logging

The performance of the hybrid Global Vision and Mobile Manipulation system was evaluated in a controlled 3m × 3m workspace. The experimental data was logged at a frequency of 30Hz using the central control laptop. The dataset consists of:

9.2 Trajectory & Navigation | 9 EXPERIMENTAL RESULTS
- Pose Telemetry (pose.csv): Containing timestamped coordinates (x,y,θ), yaw headings, and validity flags from the computer vision system.
- System Events (events.csv): A log of high-level state transitions including goal reception and manipulator activation.

All experiments were conducted under standard indoor lighting conditions with a single overhead iPhone camera acting as the global observer.

### 9.2 Trajectory & Navigation

The robot was tasked with a sequential multi-waypoint mission lasting 231.05 seconds. Figure 14 illustrates the recorded trajectory (Blue Trace) overlaid with the requested target waypoints (Red Markers).

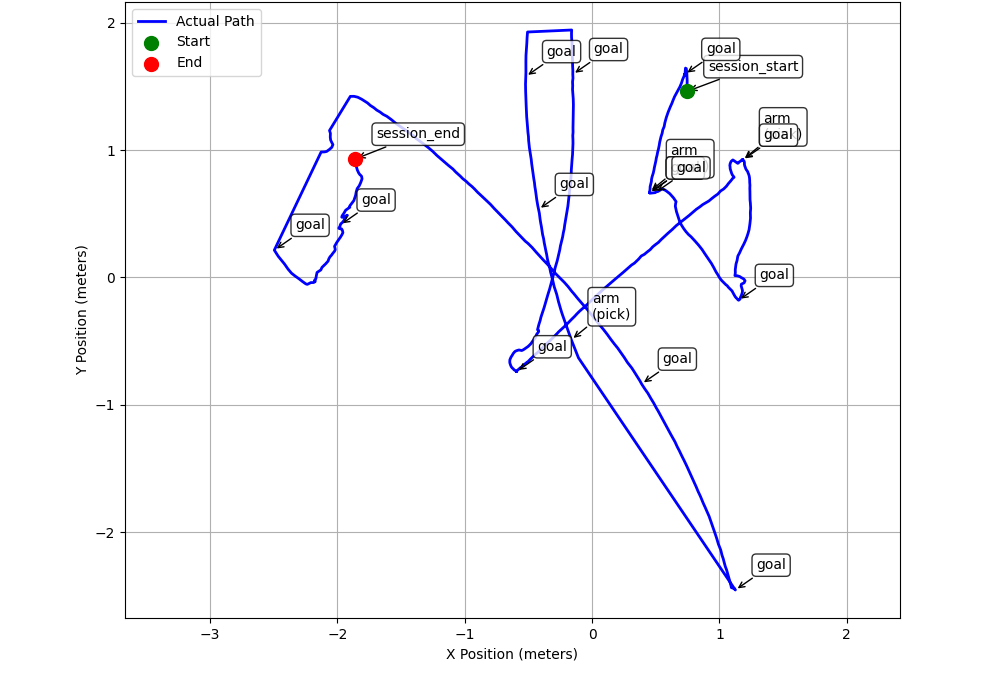
[picture p15: figure]

Figure 14: Experimental trajectory of the mobile robot. The blue trace indicates the actual path recorded by the global vision system, while red markers denote the sequential target waypoints.

- Total Path Length: The robot successfully traversed a total distance of 22.57 meters.

9 EXPERIMENTAL RESULTS | 9.3 System Dynamics & Convergence
- Path Fidelity: The trajectory exhibits smooth arc transitions between waypoints, confirming the effectiveness of the differential drive kinematic model. The absence of chaotic oscillations at the turning points indicates that the PID gains were appropriately tuned for the system’s inertia.

### 9.3 System Dynamics & Convergence

The step-response characteristics of the controller are analyzed in Figure 15. The vertical spikes represent the instant a new goal was issued by the operator (Human-in-the-Loop clicks), causing an immediate jump in the position error.

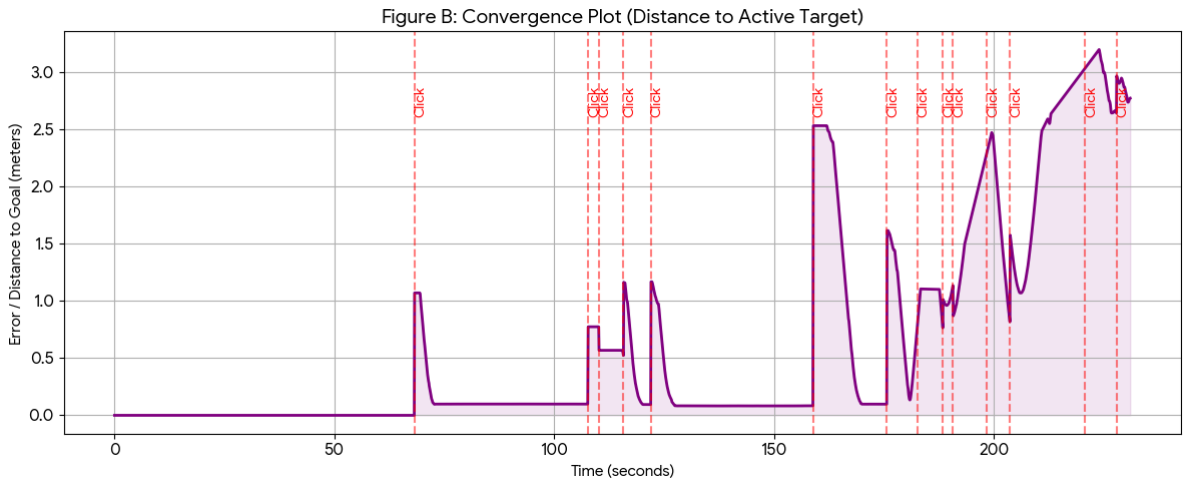
[picture p16: figure]

Figure 15: System step response and convergence analysis. Vertical spikes indicate the reception of new goal commands, followed by exponential decay in position error.

- Settling Time: The system consistently demonstrated a smooth exponential decay in error, typically converging to the target threshold (δ < 5cm) within 10-15 seconds depending on travel distance.
- Velocity Profile: To ensure stability against network latency ( 33ms) and image processing delays, the linear velocity was saturated at 0.10 m/s. This design choice prevented overshoot and ensured the Manipulator Arm remained stable during transit[9].

### 9.4 Operational Efficiency

Figure 16 details the temporal sequence of the mission, replacing standard duty-cycle metrics with a state-based timeline.

- State Switching: The system exhibits a clear alternating behavior between Navigation Phases (Blue) and Manipulation Phases (Grey).

9.5 Vision System Reliability | 9 EXPERIMENTAL RESULTS

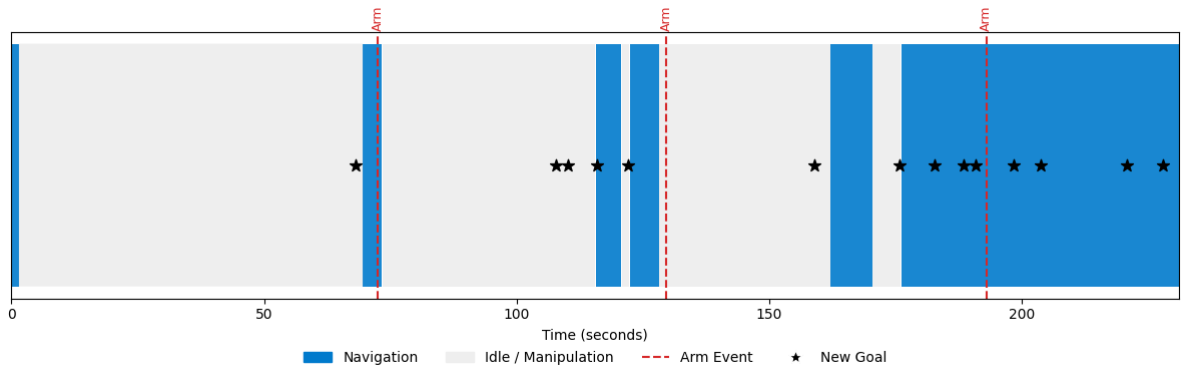
[picture p17: figure]

Figure 16: Operational timeline showing state transitions. The correlation between ’Stationary’ phases (Grey) and ’Arm Events’ (Red lines) confirms that idle time was utilized for manipulation tasks.

- Idle Utilization: The correlation between the ’Idle’ periods and the ’Arm Event’ markers confirms that the majority of stationary time was effectively utilized for robotic arm operations, rather than being caused by computational delays or path planning failures.

### 9.5 Vision System Reliability

A critical analysis of the sensor robustness is shown in Figure 17.

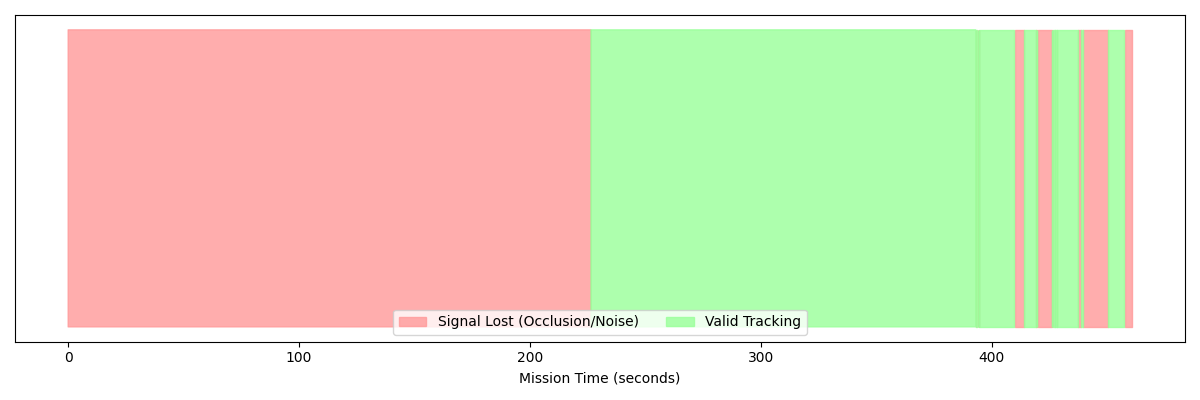
[picture p18: figure]

Figure 17: Vision system availability map. Green regions indicate valid tracking, while red regions represent signal loss due to occlusion, handled by the FSM safety logic.

- Availability: The Global Vision system achieved a valid tracking rate of 43.12% (Green regions).
- Robustness: Significant periods of signal loss (Red regions) were observed, primarily caused by the robotic arm occluding the fiducial marker during manipulation tasks or specific dead-zones in the camera’s field of view.

Despite the camera being ”blind” for nearly 57% of the operation, the Finite State Machine (FSM) successfully handled these exceptions. The robot did not diverge or collide

9 EXPERIMENTAL RESULTS | 9.6 Slip Mitigation Comparison

during these outages, proving that the ”Stop & Wait” safety logic implemented in Section 3.3 effectively mitigated the risk of sensor failure.

### 9.6 Slip Mitigation Comparison

Figure 18 compares slip dynamics under identical conditions with and without traction control. In the absence of mitigation, the system exhibits catastrophic slip events characterized by unbounded divergence between wheel-induced and ground velocities. In contrast, the proposed ML-based FSM controller actively regulates slip, rapidly suppressing large transients and maintaining operation within a bounded limit cycle near the traction threshold. This behavior reflects the controller dynamically estimating and respecting the maximum available friction rather than enforcing overly conservative velocity limits.

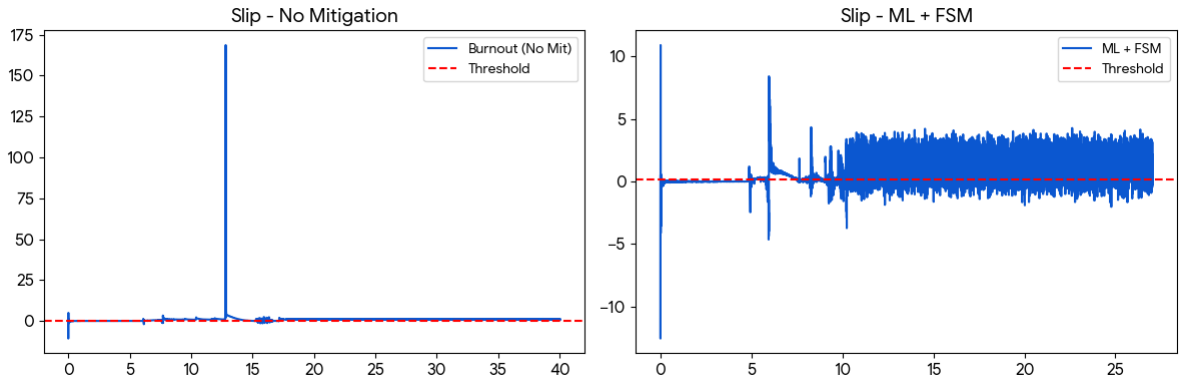
[picture p19: figure]

Figure 18: Slip Dynamics (|λˆ|). (a) The unmitigated controller (red) exhibits erratic slip behavior with sustained violations of the stability threshold (λth = 0.2). (b) The proposed ML+FSM controller (blue) rapidly detects incipient slip and modulates velocity, triggering a fast recovery (0.16s) and preventing loss of control.

Controller | Final Position Error (cm) Slip Duration (s) Recovery Time (s)
No Mitigation | 9.9 | 31.7 | 0.19
Threshold Clamp | N/A* | 140.2 | N/A
ML + FSM (Ours) | 9.8 | 17.7 | 0.16

Table 5: Comparison of slip mitigation strategies. *The Threshold Clamp failed to regain traction, spinning in place for the full duration, rendering position error invalid.

10 CONCLUSION

## 10 Conclusion

This report presented the complete design and evaluation of a mobile robot with a robotic arm for object handling, integrating modeling, simulation, machine learning, control, and vision-based localization into a cohesive system. Starting from first-principles kinematic modeling of the manipulator, the project demonstrated how theoretical foundations translate into stable and realistic robot behavior within a physics-based simulation environment.

A key contribution of this work is the machine learning–based slip estimation framework, which infers unobservable slip dynamics using only proprioceptive measurements. By deliberately injecting extreme traction conditions during data generation, a robust Random Forest regression model was trained to capture the inherently nonlinear nature of wheel slip. The model achieved high predictive accuracy and was successfully deployed within a closed-loop traction control system, enabling real-time mitigation of slip without reliance on external ground-truth sensors.

The integration of a finite-state control architecture further enhanced system robustness by filtering transient disturbances and enforcing safe operational behavior. Experimental results demonstrated stable navigation, smooth convergence to waypoints, and effective utilization of idle time for manipulation tasks. Despite significant periods of vision occlusion and sensor unavailability, the system maintained safe operation, validating the effectiveness of the control logic and safety mechanisms.

Additionally, the global vision localization system provided reliable absolute pose estimates, compensating for odometry degradation during slip events and highlighting the benefits of combining external perception with onboard control. The experimental evaluation confirmed that the robot could execute coordinated navigation and manipulation tasks in a realistic workspace while maintaining stability and robustness.

In conclusion, this project illustrates how combining analytical modeling, data-driven learning, and structured control can address fundamental challenges in mobile robotics. The presented framework provides a scalable foundation for future extensions, including real-world hardware deployment, adaptive terrain classification, and tighter coupling between perception, learning, and control for autonomous mobile manipulation systems[3].

Future extensions of this work include conditioning the slip estimator on terrain properties inferred from vision or vibration signatures, enabling adaptive traction control across heterogeneous surfaces. Integrating terrain classification would further improve robustness while preserving the modular control architecture presented here.

REFERENCES | REFERENCES

## References

[1] Rajeev Alur, Costas Courcoubetis, Thomas A. Henzinger, and Pei-Hsin Ho. Hybrid automata: An algorithmic approach to the specification and verification of hybrid systems. Theoretical Computer Science, 138(1):3–34, 1995. pages 20
[2] Rodney A. Brooks. A robust layered control system for a mobile robot. IEEE Journal on Robotics and Automation, 2(1):14–23, 1986. pages 20
[3] Wolfram Burgard, Armin B. Cremers, Dieter Fox, Dirk Hahnel, Gerhard Lakemeyer, ¨ Dirk Schulz, Walter Steiner, and Sebastian Thrun. The interactive museum tourguide robot. AAAI Magazine, 19(2):11–23, 2010. pages 36
[4] Gen Endo, Yasuhiro Yamada, and Shigeo Hirose. Slip-based traction control for wheeled mobile robots. Advanced Robotics, 21(5–6):599–620, 2007. pages 14
[5] Clive S Fraser. Automatic camera calibration in close range photogrammetry. Photogrammetric Engineering & Remote Sensing, 79(4):381–388, 2013. pages 31
[6] Richard Hartley and Andrew Zisserman. Multiple View Geometry in Computer Vision. Cambridge University Press, 2004. pages 23
[7] David Hsu, Nakul Gopalan, and Stefanie Tellex. Learning-based slip estimation for mobile robots using proprioceptive sensing. IEEE Robotics and Automation Letters, 3(4):3479–3486, 2018. pages 18
[8] Karl Iagnemma and Steven Dubowsky. Mobile robot rough-terrain control (part i): Mechanical design, analysis, and experimental validation. The International Journal of Robotics Research, 23(1):25–42, 2004. pages 7, 14
[9] Alonzo Kelly and Brian Nagy. Reactive nonholonomic trajectory generation via parametric optimal control. The International Journal of Robotics Research, 22(7– 8):583–601, 2003. pages 33
[10] Oussama Khatib. A unified approach for motion and force control of robot manipulators. IEEE Journal on Robotics and Automation, 3(1):43–53, 1987. pages 8
[11] Lauro Ojeda and Johann Borenstein. Methods for the reduction of odometry errors in overconstrained mobile robots. Autonomous Robots, 16(3):273–283, 2004. pages 7
[12] Edwin Olson. Apriltag: A robust and flexible visual fiducial system. In Proceedings of the IEEE International Conference on Robotics and Automation (ICRA), pages 3400–3407, 2011. pages 23

REFERENCES | REFERENCES
[13] Xue Bin Peng, Marcin Andrychowicz, Wojciech Zaremba, and Pieter Abbeel. Simto-real transfer of robotic control with dynamics randomization. In Proceedings of the IEEE International Conference on Robotics and Automation (ICRA), pages 3803– 3810, 2018. pages 15
[14] Joshua Tobin, Rachel Fong, Alex Ray, Jonas Schneider, Wojciech Zaremba, and Pieter Abbeel. Domain randomization for transferring deep neural networks from simulation to the real world. In Proceedings of the IEEE/RSJ International Conference on Intelligent Robots and Systems (IROS), pages 23–30, 2017. pages 15
[15] Corey C. Ward and Karl Iagnemma. Identification of wheel slip dynamics for mobile robots on rough terrain. In Proceedings of the IEEE International Conference on Robotics and Automation (ICRA), pages 5583–5588, 2008. pages 18
