AlanoudAlsalem/Dimver/(commit log)

2026-01-01 Arduino Firmware
2026-01-05 raspberry_pi code
2026-01-11 Add ML Slip Detection
    [burnout_data.csv, final_slip_data.csv, grip_data.csv, master_dataset.csv, robot_data.csv, slip_data.csv, truth_data.csv, wall_data.csv]
